texane/voltage_controller/doc/dia/io/main.jpeg

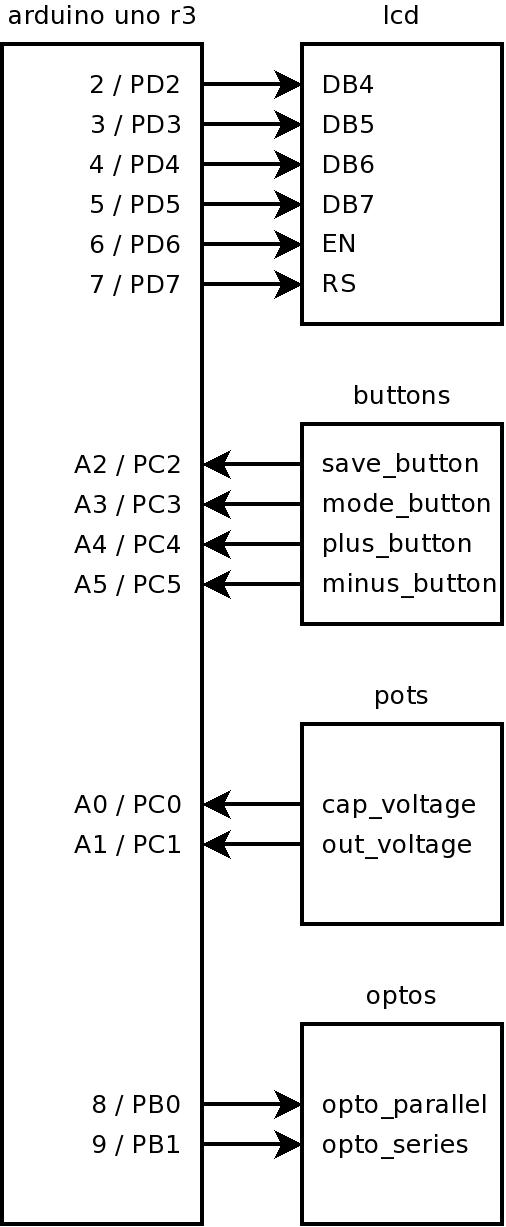
doc/dia/io/main.jpeg
