texane/voltage_controller/doc/eagle/uno_shield/main.png

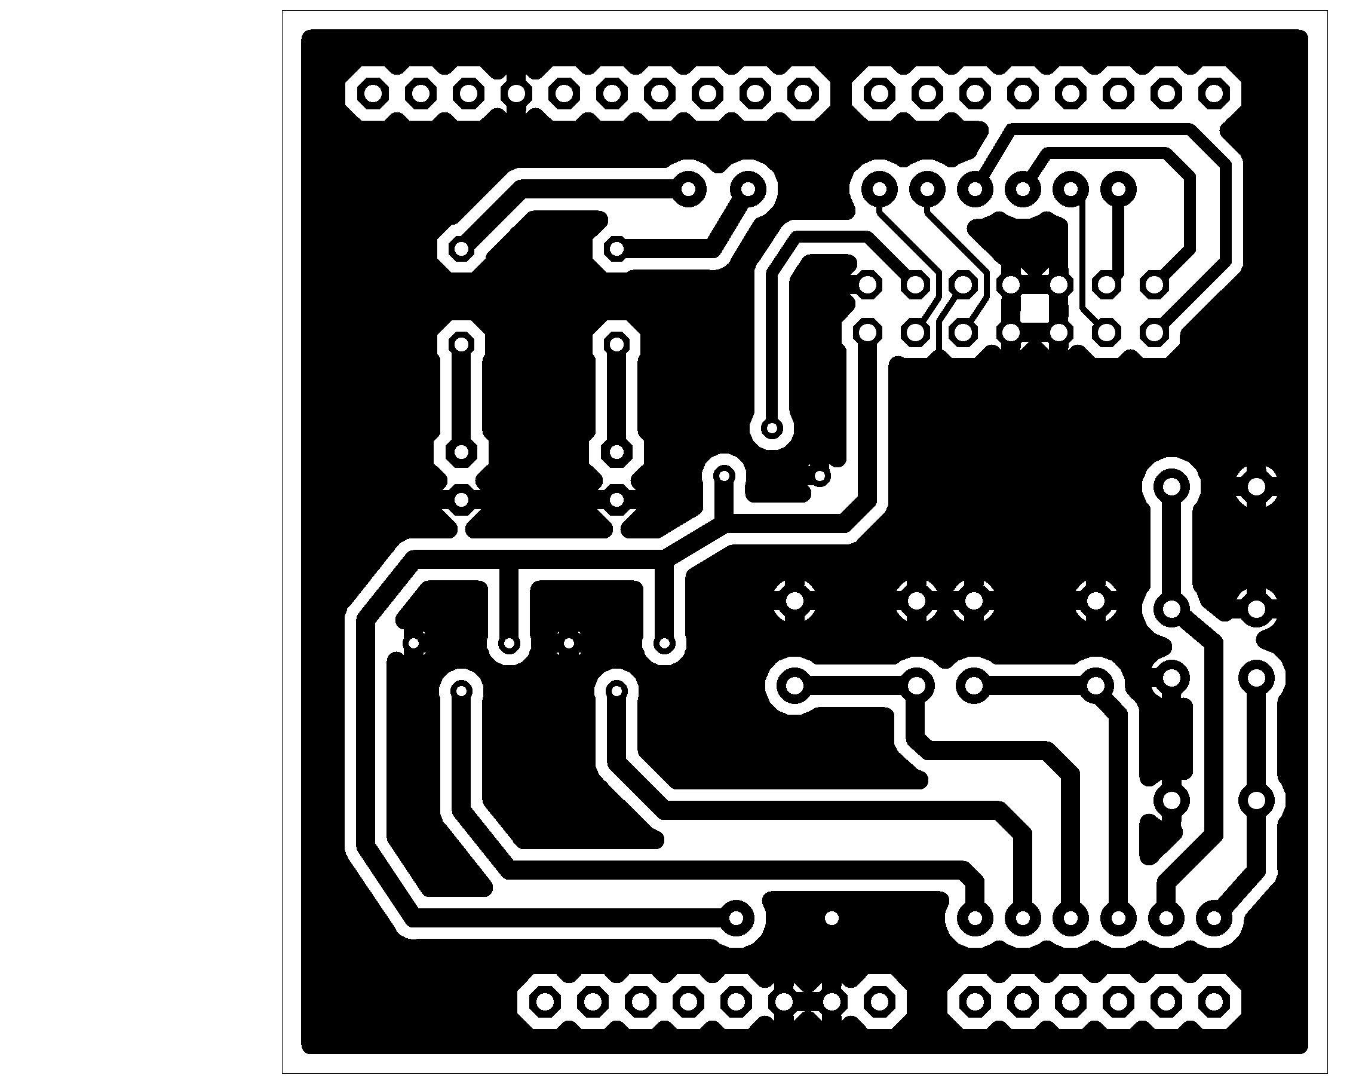
doc/eagle/uno_shield/main.png
