texane/voltage_controller/doc/eagle/voltage_scaling_stage/main.png

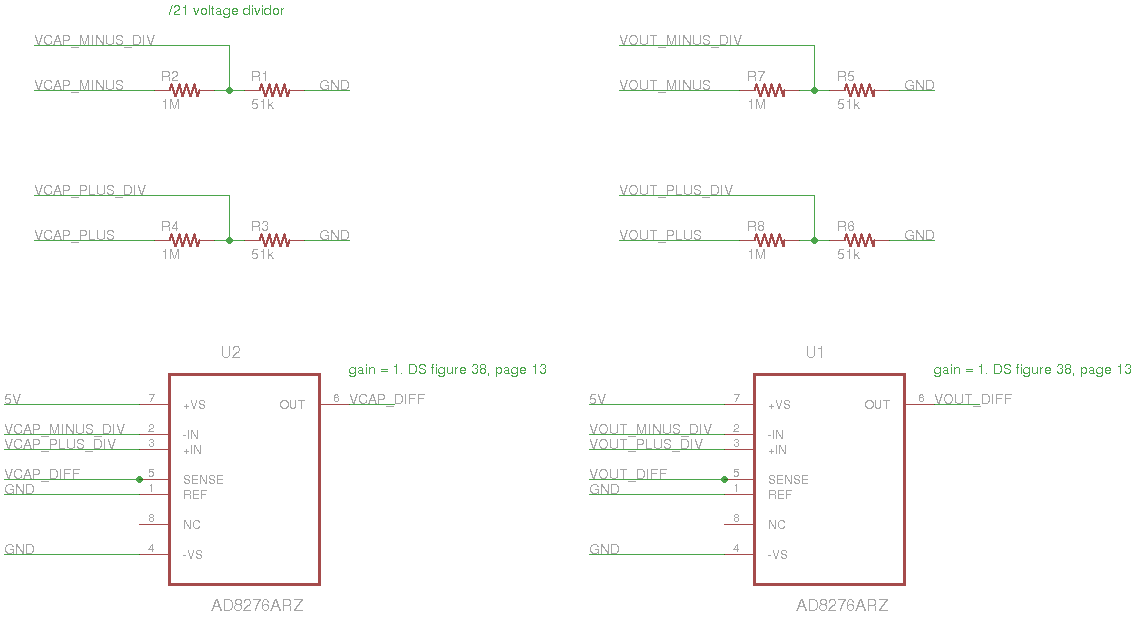
doc/eagle/voltage_scaling_stage/main.png
