texane/voltage_controller/doc/eagle/uno_shield/main.brd

## EAGLE design doc/eagle/uno_shield/main.brd (2013-05-20)

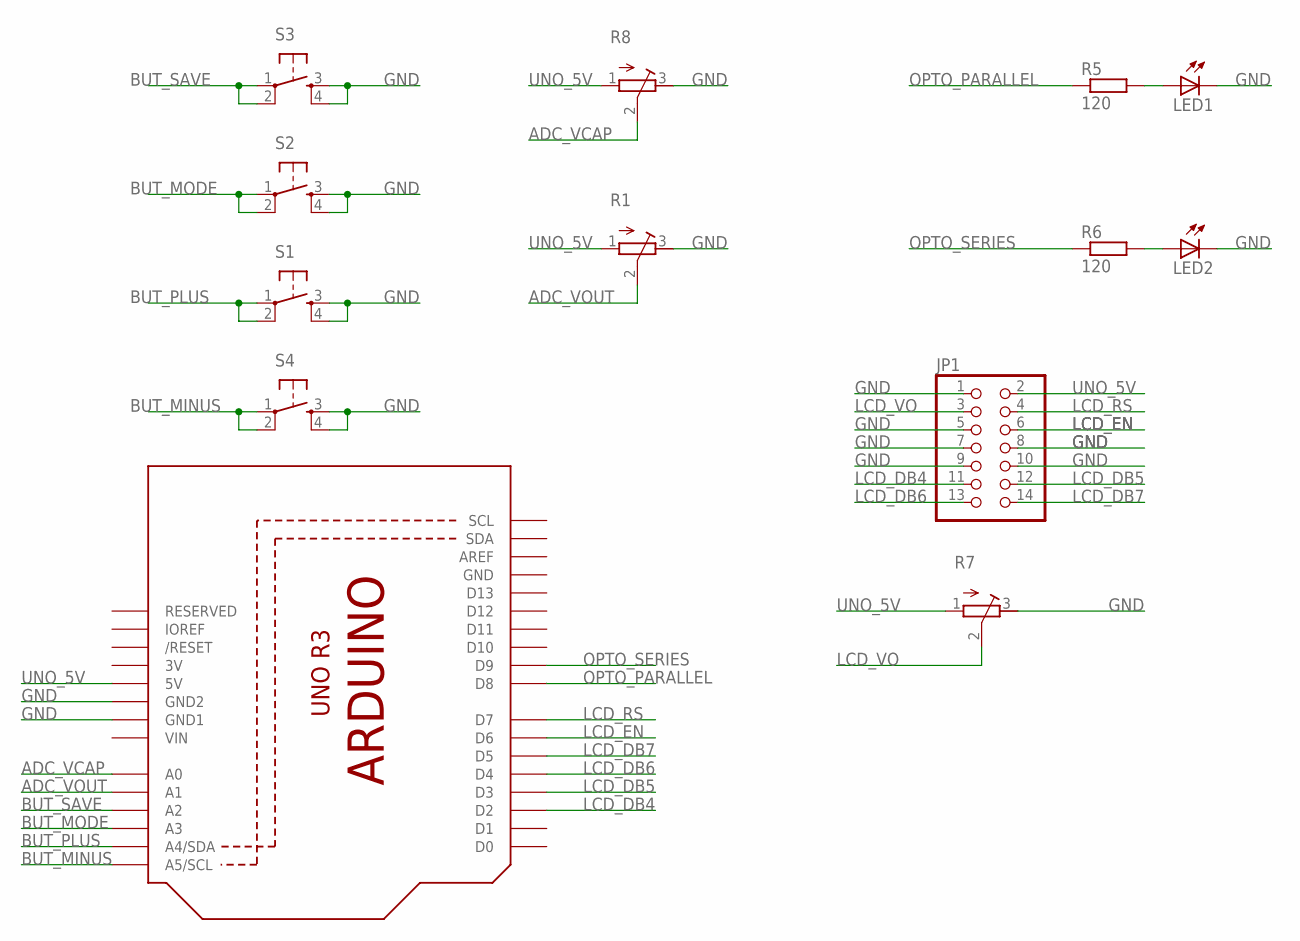
[picture p4: schematic main.sch]

Parts:
JP1: PINHD-2X7; 2X07
LED1, LED2: LED5MM
R1, R7, R8: R-TRIMM3339P; RTRIM3339P
R5, R6: 120; 0204/5
S1, S2, S3, S4: TAC_SWITCHPTH; TACTILE-PTH
U1: ARDUINOR3-BPLACE

Connections:
3V: U1.3V
ADC_VCAP: R8.2 (S), U1.A0
ADC_VOUT: R1.2 (S), U1.A1
BUT_MINUS: S4.1, S4.2, U1.A5 (A5/SCL)
BUT_MODE: S2.1, S2.2, U1.A3
BUT_PLUS: S1.1, S1.2, U1.A4 (A4/SDA)
BUT_SAVE: S3.1, S3.2, U1.A2
GND: JP1.1, JP1.5, JP1.7, JP1.8, JP1.9, JP1.10, LED1.K (C), LED2.K (C), R1.3 (A), R7.3 (A), R8.3 (A), S1.3, S1.4, S2.3, S2.4, S3.3, S3.4, S4.3, S4.4, U1.GND, U1.GND1, U1.GND2
LCD_DB4: JP1.11, U1.D2
LCD_DB5: JP1.12, U1.D3
LCD_DB6: JP1.13, U1.D4
LCD_DB7: JP1.14, U1.D5
LCD_EN: JP1.6, U1.D6
LCD_RS: JP1.4, U1.D7
LCD_VO: JP1.3, R7.2 (S)
unnamed: LED1.A, R5.2
unnamed: LED2.A, R6.2
OPTO_PARALLEL: R5.1, U1.D8
OPTO_SERIES: R6.1, U1.D9
UNO_5V: JP1.2, R1.1 (E), R7.1 (E), R8.1 (E), U1.5V
VIN: U1.VIN

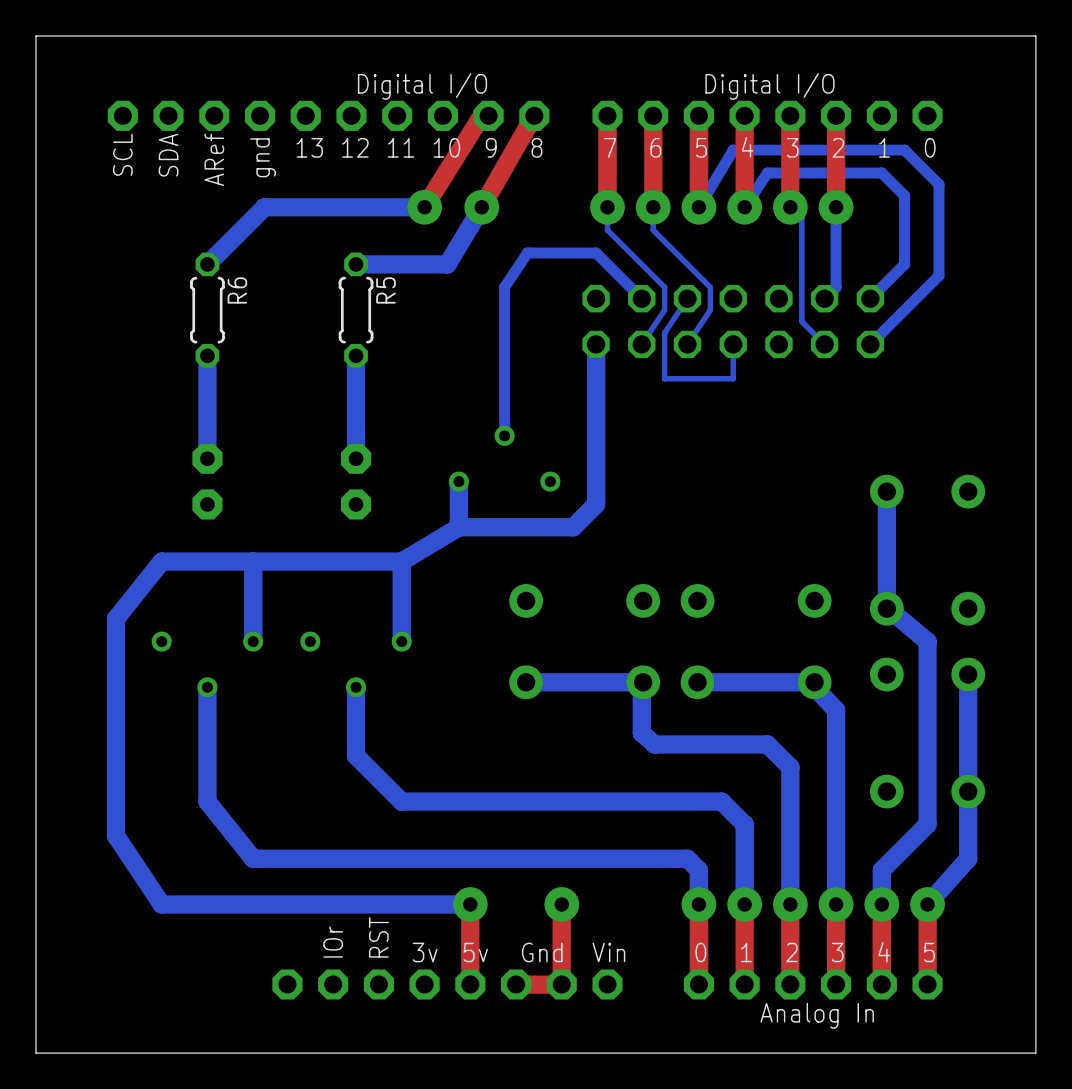
[picture p5: board main.brd from above]

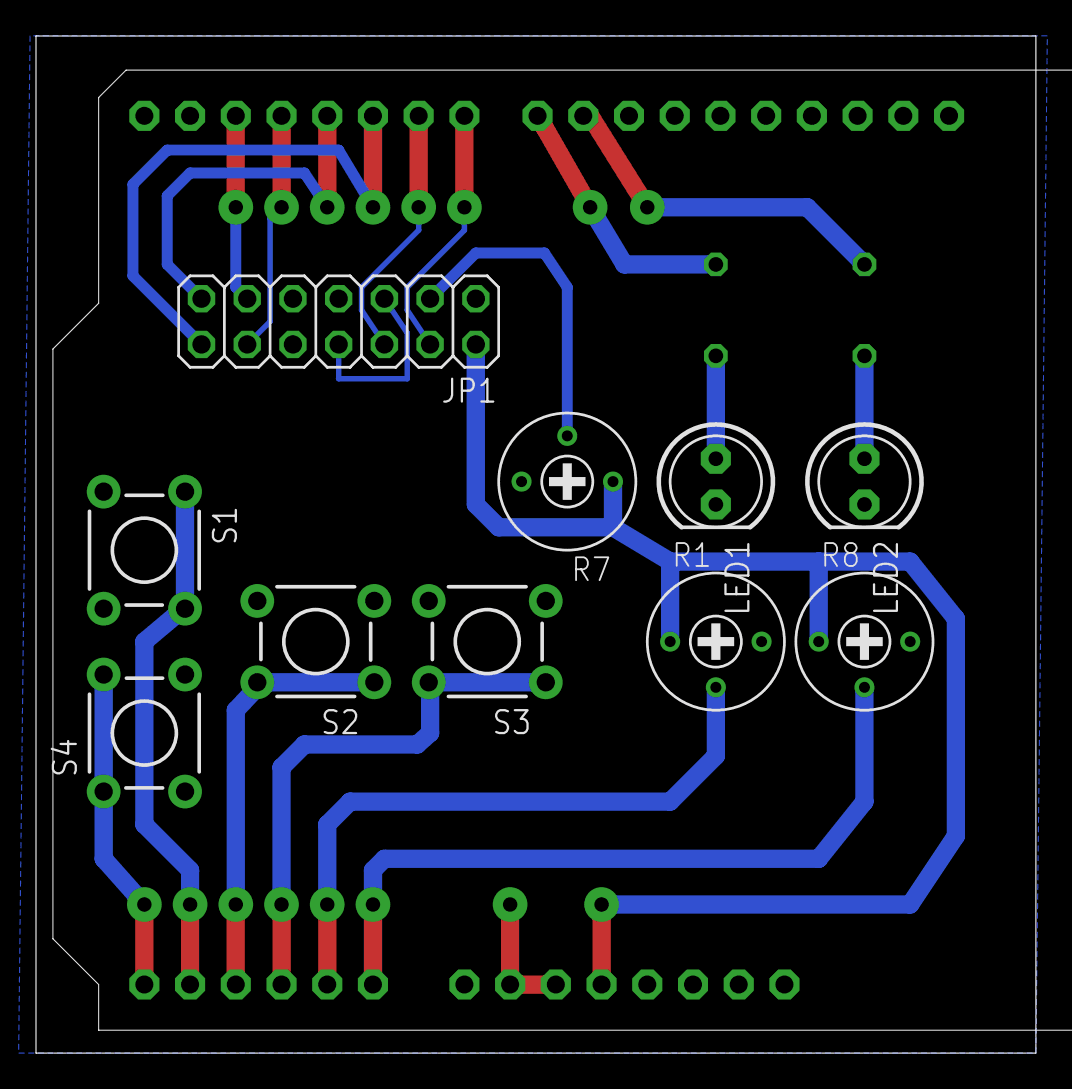
[picture p6: board main.brd from below]

Board: 2 copper layers, 55.5 x 56.5 mm, 13 parts (10 on the bottom side), 19 nets.
