texane/voltage_controller/(commit log)

2013-05-19 [ update ] button handling
2013-05-19 [ update ] adc
2013-05-19 [ add ] eagle/uno_shield
    [main.brd, main.sch]
2013-05-20 [ add ] routed board, main.png
    [main.brd, main.sch]
2013-05-20 [ fix ] uno_shield board
    [main.brd]
2013-05-20 [ update, fix ] add debugging. check conf value range. buttons pressed low.
2013-05-20 [ update ] adc, single conversion mode
2013-05-21 [ update ] button handling logic
2013-05-23 [ add ] eagle/voltage_scaling_stage
    [main.sch]
2013-05-23 [ update ] eagle/voltage_scaling_stage
    [main.sch]
2013-05-23 [ update ] voltage_scaling_stage
2013-05-23 [ add ] voltage_scaling_stage/notes
2013-05-23 [ add ] voltage_scaling_stage/main.png
